EyalYe/unicorne/docs/led-map.md

# LED map

Generated by `tools/led_map.py` from the board, by walking the data chain from `LED_DIN`.
**Index** is the LED's position in the chain, 0-based (the pixel number ZMK and QMK use).
**LED** names the spot: `L K12` is the LED under the left key in row 1, column 2 of that half's
grid (thumbs `L T0`..`L T2`); `L G3` is left underglow spot 3. **Matrix** is the key's
row and column in the wired 6 x 7 matrix (left half rows 0-2, right half rows 3-5).

| Index | Ref | LED | Type | Switch | Matrix row | Matrix col | Note |
|---:|---|---|---|---|---:|---:|---|
| 0 | LED1 | L T2 | key | SW21 | 2 | 6 |  |
| 1 | LED2 | L T1 | key | SW20 | 1 | 6 |  |
| 2 | LED3 | L T0 | key | SW19 | 0 | 6 |  |
| 3 | LED4 | L G5 | underglow |  |  |  |  |
| 4 | LED5 | L K25 | key | SW18 | 2 | 5 |  |
| 5 | LED6 | L K24 | key | SW17 | 2 | 4 |  |
| 6 | LED7 | L K23 | key | SW16 | 2 | 3 |  |
| 7 | LED8 | L G4 | underglow |  |  |  |  |
| 8 | LED9 | L K22 | key | SW15 | 2 | 2 |  |
| 9 | LED10 | L K21 | key | SW14 | 2 | 1 |  |
| 10 | LED11 | L G3 | underglow |  |  |  |  |
| 11 | LED12 | L K11 | key | SW8 | 1 | 1 |  |
| 12 | LED13 | L G0 | underglow |  |  |  |  |
| 13 | LED14 | L K01 | key | SW2 | 0 | 1 |  |
| 14 | LED15 | L K02 | key | SW3 | 0 | 2 |  |
| 15 | LED16 | L K12 | key | SW9 | 1 | 2 |  |
| 16 | LED17 | L K13 | key | SW10 | 1 | 3 |  |
| 17 | LED18 | L G1 | underglow |  |  |  |  |
| 18 | LED19 | L K03 | key | SW4 | 0 | 3 |  |
| 19 | LED20 | L K04 | key | SW5 | 0 | 4 |  |
| 20 | LED21 | L K14 | key | SW11 | 1 | 4 |  |
| 21 | LED22 | L K15 | key | SW12 | 1 | 5 |  |
| 22 | LED23 | L G2 | underglow |  |  |  |  |
| 23 | LED24 | L K05 | key | SW6 | 0 | 5 |  |
| 24 | LED25 | R K05 | key | SW27 | 3 | 5 |  |
| 25 | LED26 | R G2 | underglow |  |  |  |  |
| 26 | LED27 | R K15 | key | SW33 | 4 | 5 |  |
| 27 | LED28 | R K25 | key | SW39 | 5 | 5 |  |
| 28 | LED29 | R G5 | underglow |  |  |  |  |
| 29 | LED30 | R T2 | key | SW42 | 5 | 6 |  |
| 30 | LED31 | R T1 | key | SW41 | 4 | 6 |  |
| 31 | LED32 | R T0 | key | SW40 | 3 | 6 |  |
| 32 | LED33 | R K24 | key | SW38 | 5 | 4 |  |
| 33 | LED34 | R K14 | key | SW32 | 4 | 4 |  |
| 34 | LED35 | R K04 | key | SW26 | 3 | 4 |  |
| 35 | LED36 | R K03 | key | SW25 | 3 | 3 |  |
| 36 | LED37 | R G1 | underglow |  |  |  |  |
| 37 | LED38 | R K13 | key | SW31 | 4 | 3 |  |
| 38 | LED39 | R K23 | key | SW37 | 5 | 3 |  |
| 39 | LED40 | R G4 | underglow |  |  |  |  |
| 40 | LED41 | R K22 | key | SW36 | 5 | 2 |  |
| 41 | LED42 | R K12 | key | SW30 | 4 | 2 |  |
| 42 | LED43 | R K02 | key | SW24 | 3 | 2 |  |
| 43 | LED44 | R K01 | key | SW23 | 3 | 1 |  |
| 44 | LED45 | R G0 | underglow |  |  |  |  |
| 45 | LED46 | R K11 | key | SW29 | 4 | 1 |  |
| 46 | LED47 | R G3 | underglow |  |  |  |  |
| 47 | LED48 | R K21 | key | SW35 | 5 | 1 |  |
| 48 | LED49 | R K20 | key | SW34 | 5 | 0 | outer pinky (breaks off) |
| 49 | LED50 | R K10 | key | SW28 | 4 | 0 | outer pinky (breaks off) |
| 50 | LED51 | R K00 | key | SW22 | 3 | 0 | outer pinky (breaks off) |
| 51 | LED52 | L K00 | key | SW1 | 0 | 0 | outer pinky (breaks off) |
| 52 | LED53 | L K10 | key | SW7 | 1 | 0 | outer pinky (breaks off) |
| 53 | LED54 | L K20 | key | SW13 | 2 | 0 | outer pinky (breaks off) |

54 LEDs. The outer pinky LEDs are last, so on the 36-key build the chain ends at index 47.
