EyalYe/unicorne/export/plate/unicorne-choc-42-plate.png

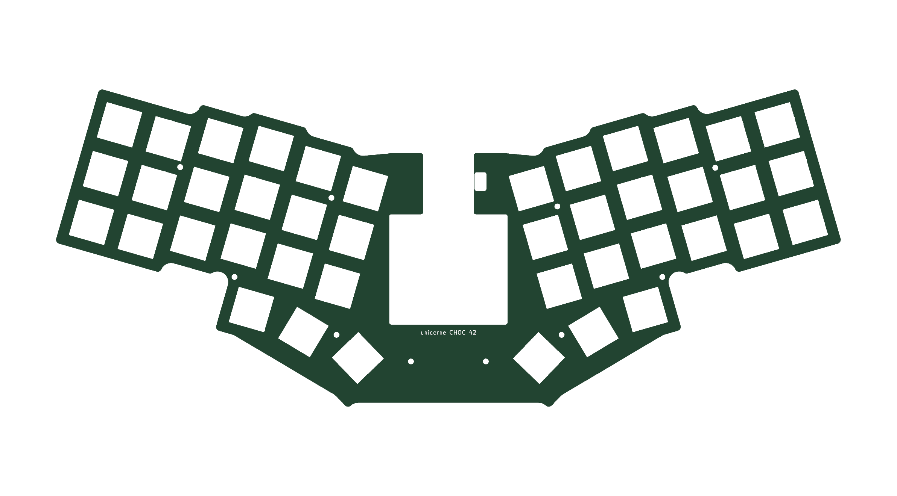
export/plate/unicorne-choc-42-plate.png
