EyalYe/unicorne/export/unicorne-choc-bottom.png

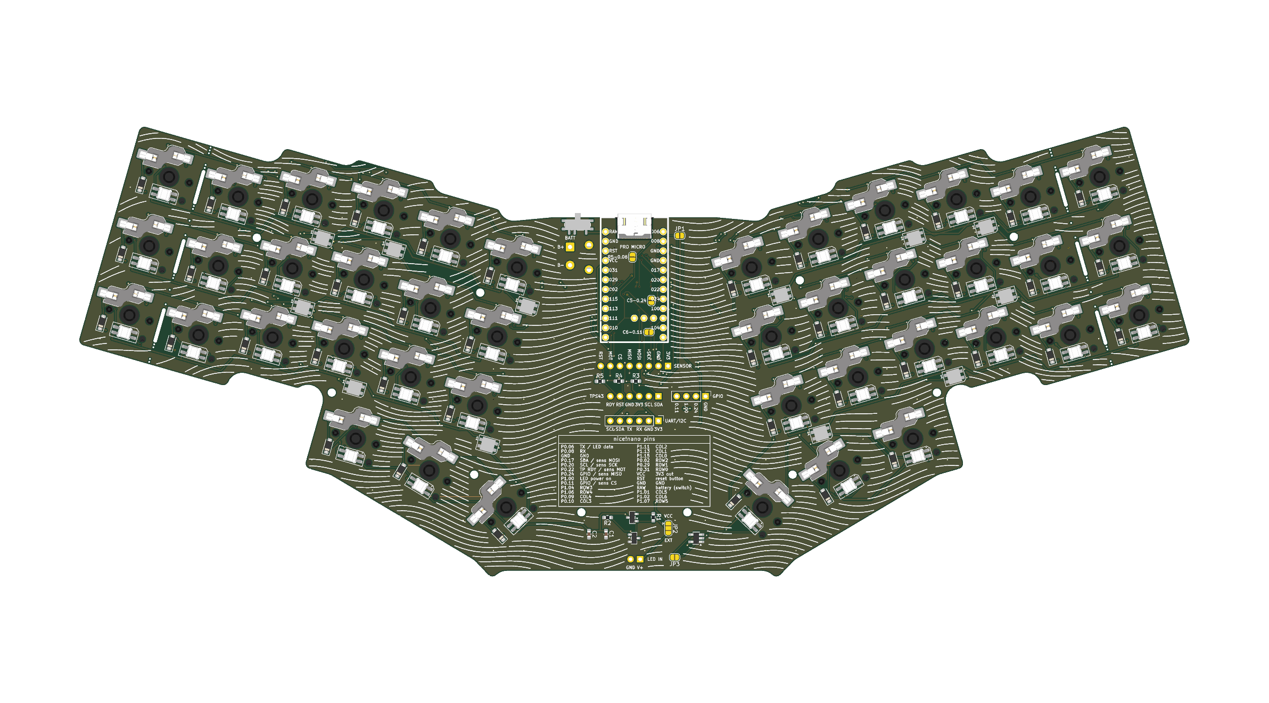
export/unicorne-choc-bottom.png
