EyalYe/unicorne/export/unicorne-mx-bottom.png

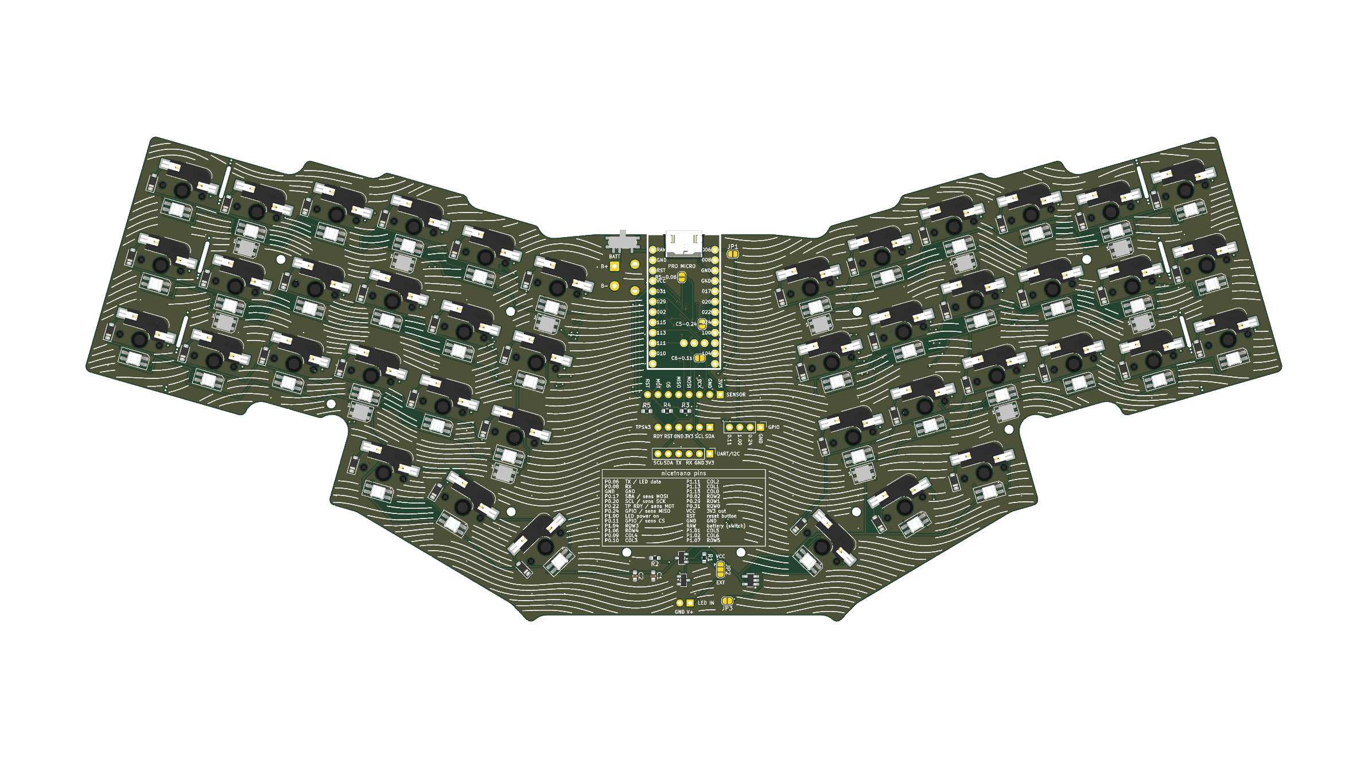
export/unicorne-mx-bottom.png
