EyalYe/unicorne/export/plate/unicorne-mx-36-plate.step

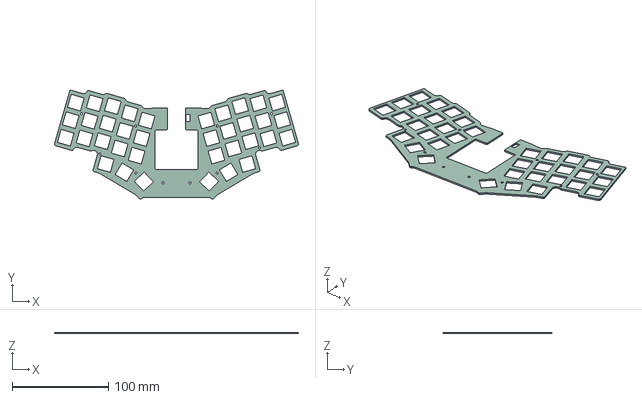
[picture p6: CAD file, 2026-10-26]
export/plate/unicorne-mx-36-plate.step
253.8 x 113.5 x 1.41 mm
