EyalYe/unicorne/export/unicorne-choc.step

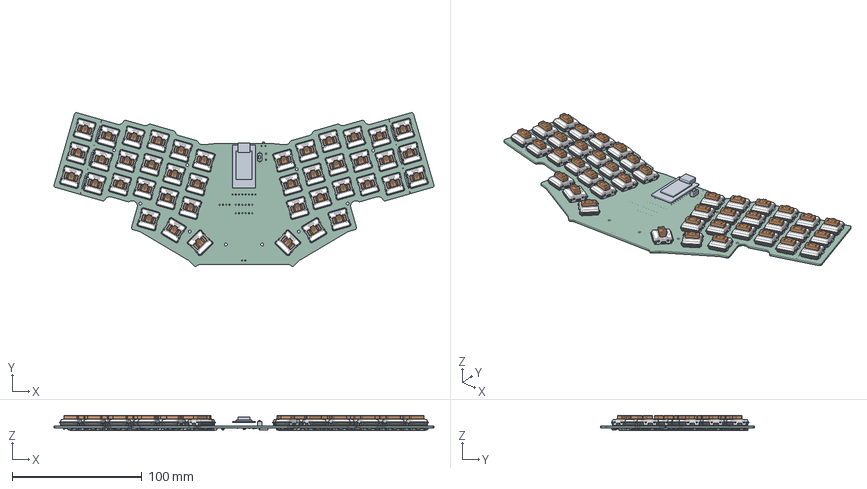
[picture p7: CAD file, 2026-10-26]
export/unicorne-choc.step
293.4 x 118.8 x 11.5 mm
SW_Hotswap_Kailh_Choc_v1 x 42
SW_Kailh_Choc_V1_cp x 42
tactile_3.5x6_h43_box
nice_nano_box
D_SOD-123 x 42
Pin1 x 42
Pin2 x 42
Pin3 x 42
Pin4 x 42
sk6812mini_box x 12
R_0603_1608Metric x 5
C_0603_1608Metric x 2
SOT-23 x 2
msk12c02_box
SOT-23-5
unicorne-choc_PCB
