EyalYe/unicorne/export/plate/unicorne-mx-42-plate.step

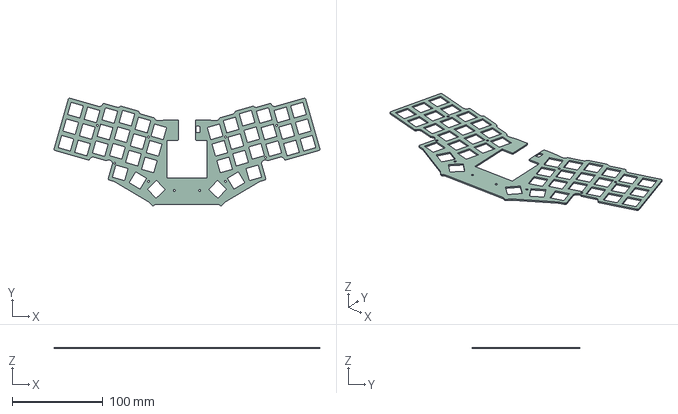
[picture p8: CAD file, 2026-10-26]
export/plate/unicorne-mx-42-plate.step
293.4 x 118.8 x 1.41 mm
