EyalYe/unicorne/export/unicorne-mx.step

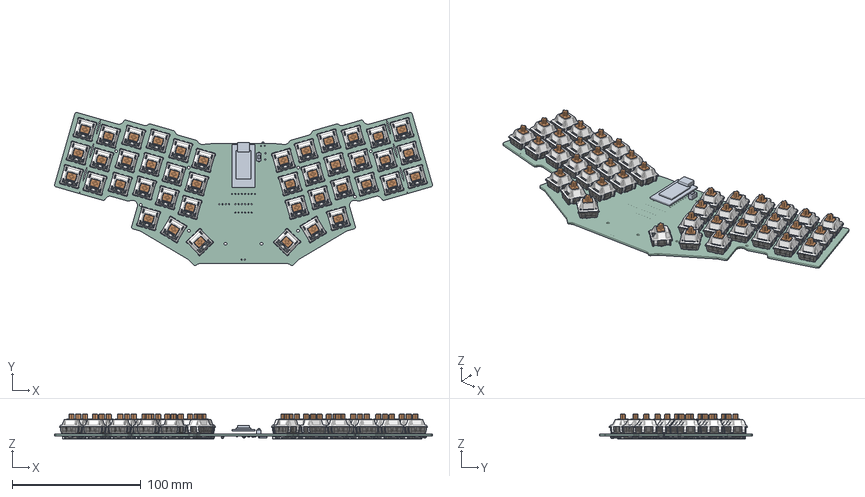
[picture p9: CAD file, 2026-10-26]
export/unicorne-mx.step
293.4 x 118.8 x 19.0 mm
SW_Hotswap_Kailh_cp x 42
SW_Cherry_MX_PCB_cp x 42
tactile_3.5x6_h43_box
nice_nano_box
sk6812mini_box x 12
Pin1 x 42
Pin2 x 42
Pin3 x 42
Pin4 x 42
D_SOD-123 x 42
msk12c02_box
R_0603_1608Metric x 5
SOT-23 x 2
C_0603_1608Metric x 2
SOT-23-5
unicorne_PCB
