EyalYe/unicorne/export/plate/unicorne-choc-36-plate.step

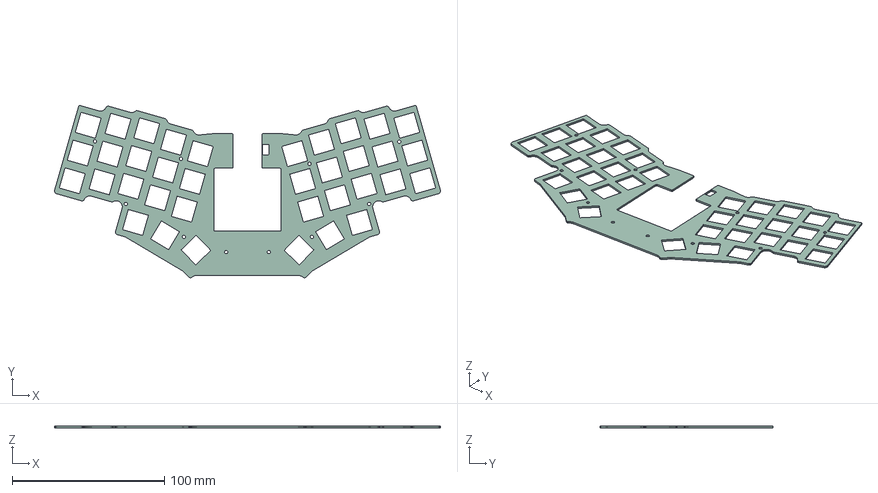
[picture p10: CAD file, 2026-10-26]
export/plate/unicorne-choc-36-plate.step
253.8 x 113.5 x 1.11 mm
