EyalYe/unicorne/export/plate/unicorne-choc-42-plate.step

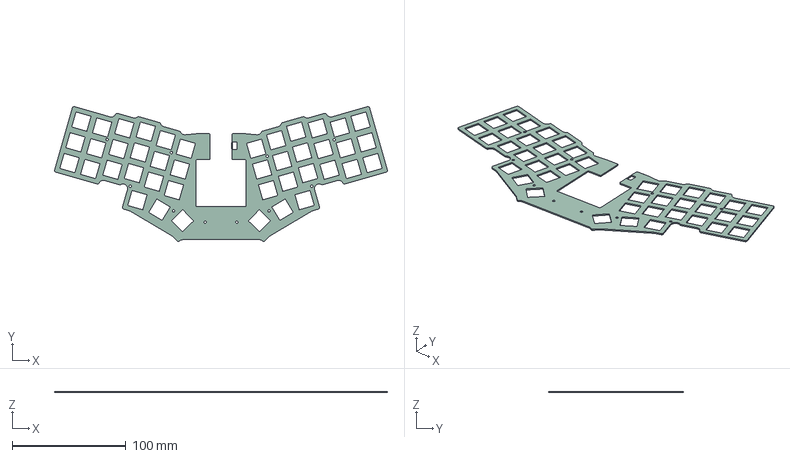
[picture p11: CAD file, 2026-10-26]
export/plate/unicorne-choc-42-plate.step
293.4 x 118.8 x 1.11 mm
