EyalYe/unicorne/export/plate/unicorne-mx-plate.dxf

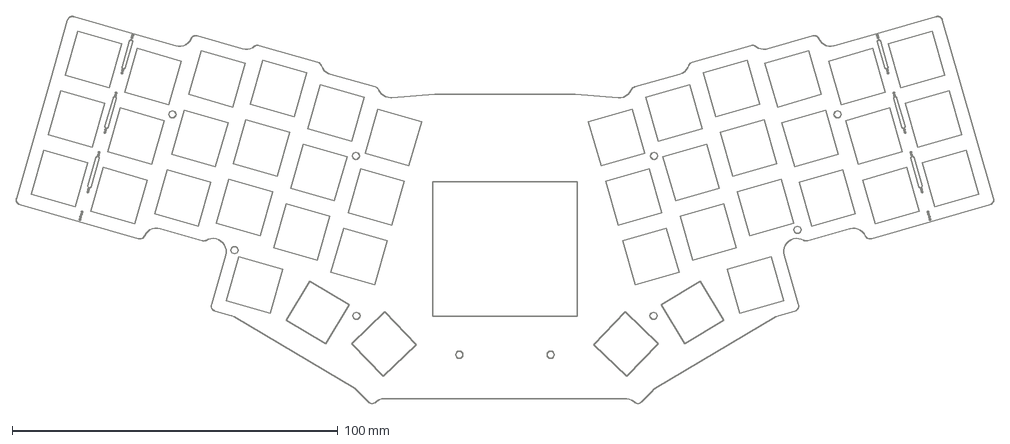
[picture p12: CAD file, 2026-10-25]
export/plate/unicorne-mx-plate.dxf
299.9 x 118.8 mm
