EyalYe/unicorne/export/plate/unicorne-choc-plate.dxf

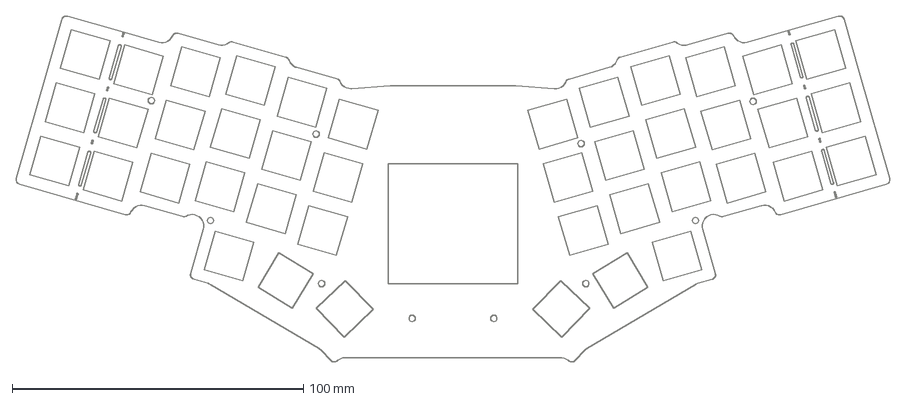
[picture p13: CAD file, 2026-10-25]
export/plate/unicorne-choc-plate.dxf
299.9 x 118.8 mm
