EyalYe/unicorne/(list of files, cad)

Other CAD files:
export/plate/unicorne-choc-36-plate.dxf
export/plate/unicorne-choc-42-plate.dxf
export/plate/unicorne-mx-36-plate.dxf
export/plate/unicorne-mx-42-plate.dxf
