EyalYe/unicorne/unicorne.kicad_pcb

## KiCad design unicorne.kicad_pcb (2026-10-26)

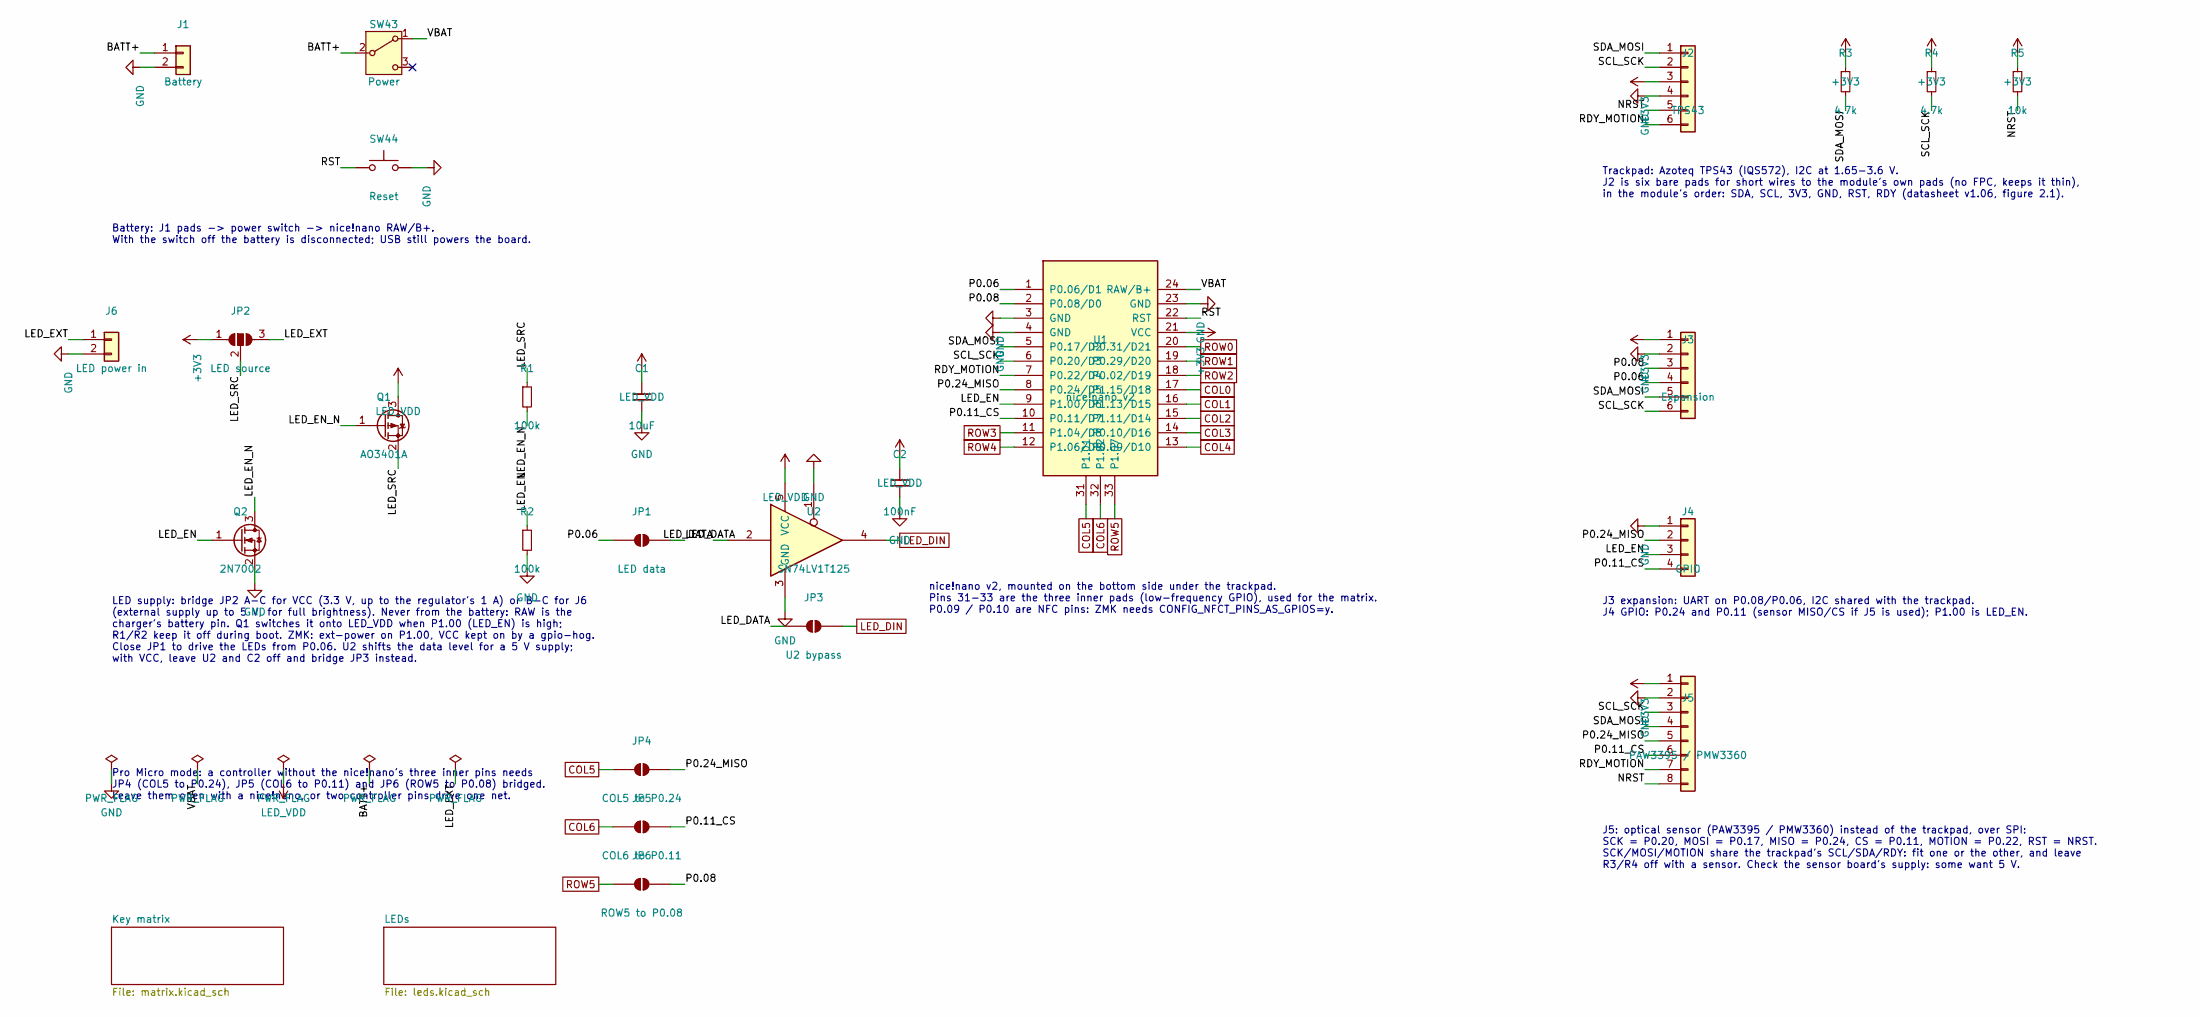
[picture p14: schematic unicorne.kicad_sch]

Parts:
C1: 10uF; C_0603_1608Metric_Pad1.08x0.95mm_HandSolder
C2: 100nF; C_0603_1608Metric_Pad1.08x0.95mm_HandSolder
J1: Battery; SolderWire-0.5sqmm_1x02_P4.8mm_D0.9mm_OD2.3mm
J2: TPS43; PinHeader_1x06_P2.54mm_Vertical
J3: Expansion; PinHeader_1x06_P2.54mm_Vertical
J4: GPIO; PinHeader_1x04_P2.54mm_Vertical
J5: PAW3395 / PMW3360; PinHeader_1x08_P2.54mm_Vertical
J6: LED power in; PinHeader_1x02_P2.54mm_Vertical
JP1: LED data; SolderJumper-2_P1.3mm_Open_RoundedPad1.0x1.5mm
JP2: LED source; SolderJumper-3_P1.3mm_Open_RoundedPad1.0x1.5mm
JP3: U2 bypass; SolderJumper-2_P1.3mm_Open_RoundedPad1.0x1.5mm
JP4: COL5 to P0.24; SolderJumper-2_P1.3mm_Open_RoundedPad1.0x1.5mm
JP5: COL6 to P0.11; SolderJumper-2_P1.3mm_Open_RoundedPad1.0x1.5mm
JP6: ROW5 to P0.08; SolderJumper-2_P1.3mm_Open_RoundedPad1.0x1.5mm
Q1: AO3401A; SOT-23
Q2: 2N7002; SOT-23
R1, R2: 100k; R_0603_1608Metric_Pad0.98x0.95mm_HandSolder
R3, R4: 4.7k; R_0603_1608Metric_Pad0.98x0.95mm_HandSolder
R5: 10k; R_0603_1608Metric_Pad0.98x0.95mm_HandSolder
SW43: Power; SW_SPDT_Shouhan_MSK12C02
SW44: Reset; SW_Tactile_SPST_3.5x6mm_H4.3mm_THT
U1: nice!nano v2; nice_nano
U2: SN74LV1T125; SOT-23-5_HandSoldering

Connections:
+3V3: J2.3, J3.1, J5.1, JP2.1 (A), R3.1, R4.1, R5.1, U1.21 (VCC)
/BATT+: J1.1, SW43.2 (B)
/LED_DATA: JP1.2 (B), JP3.1 (A), U2.2
/LED_EN: J4.3, Q2.1 (G), R2.1, U1.9 (P1.00/D6)
/LED_EN_N: Q1.1 (G), Q2.3 (D), R1.2
/LED_EXT: J6.1, JP2.3 (B)
/LED_SRC: JP2.2 (C), Q1.2 (S), R1.1
/NRST: J2.5, J5.8, R5.2
/P0.06: J3.4, JP1.1 (A), U1.1 (P0.06/D1)
/P0.08: J3.3, JP6.2 (B), U1.2 (P0.08/D0)
/P0.11_CS: J4.4, J5.6, JP5.2 (B), U1.10 (P0.11/D7)
/P0.24_MISO: J4.2, J5.5, JP4.2 (B), U1.8 (P0.24/D5)
/RDY_MOTION: J2.6, J5.7, U1.7 (P0.22/D4)
/RST: SW44.1, U1.22 (RST)
/SCL_SCK: J2.2, J3.6, J5.3, R4.2, U1.6 (P0.20/D3)
/SDA_MOSI: J2.1, J3.5, J5.4, R3.2, U1.5 (P0.17/D2)
/VBAT: SW43.1 (A), U1.24 (RAW/B+)
COL0: U1.17 (P1.15/D18); also elsewhere on the board
COL1: U1.16 (P1.13/D15); also elsewhere on the board
COL2: U1.15 (P1.11/D14); also elsewhere on the board
COL3: U1.14 (P0.10/D16); also elsewhere on the board
COL4: U1.13 (P0.09/D10); also elsewhere on the board
COL5: JP4.1 (A), U1.31 (P1.01); also elsewhere on the board
COL6: JP5.1 (A), U1.32 (P1.02); also elsewhere on the board
GND: C1.2, C2.2, J1.2, J2.4, J3.2, J4.1, J5.2, J6.2, Q2.2 (S), R2.2, SW44.2, U1.3 (GND), U1.4 (GND), U1.23 (GND), U2.1, U2.3 (GND); also elsewhere on the board
LED_DIN: JP3.2 (B), U2.4; also elsewhere on the board
LED_VDD: C1.1, C2.1, Q1.3 (D), U2.5 (VCC); also elsewhere on the board
ROW0: U1.20 (P0.31/D21); also elsewhere on the board
ROW1: U1.19 (P0.29/D20); also elsewhere on the board
ROW2: U1.18 (P0.02/D19); also elsewhere on the board
ROW3: U1.11 (P1.04/D8); also elsewhere on the board
ROW4: U1.12 (P1.06/D9); also elsewhere on the board
ROW5: JP6.1 (A), U1.33 (P1.07); also elsewhere on the board

Notes on the sheet:
nice!nano v2, mounted on the bottom side under the trackpad. Pins 31-33 are the three inner pads (low-frequency GPIO), used for the matrix. P0.09 / P0.10 are NFC pins: ZMK needs CONFIG_NFCT_PINS_AS_GPIOS=y.
Battery: J1 pads -> power switch -> nice!nano RAW/B+. With the switch off the battery is disconnected; USB still powers the board.
Pro Micro mode: a controller without the nice!nano's three inner pins needs JP4 (COL5 to P0.24), JP5 (COL6 to P0.11) and JP6 (ROW5 to P0.08) bridged. Leave them open with a nice!nano, or two controller pins drive one net.
LED supply: bridge JP2 A-C for VCC (3.3 V, up to the regulator's 1 A) or B-C for J6 (external supply up to 5 V, for full brightness). Never from the battery: RAW is the charger's battery pin. Q1 switches it onto LED_VDD when P1.00 (LED_EN) is high; R1/R2 keep it off during boot. ZMK: ext-power on P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
J5: optical sensor (PAW3395 / PMW3360) instead of the trackpad, over SPI: SCK = P0.20, MOSI = P0.17, MISO = P0.24, CS = P0.11, MOTION = P0.22, RST = NRST. SCK/MOSI/MOTION share the trackpad's SCL/SDA/RDY: fit one or the other, and leave R3/R4 off with a sensor. Check the sensor board's supply: some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
Trackpad: Azoteq TPS43 (IQS572), I2C at 1.65-3.6 V. J2 is six bare pads for short wires to the module's own pads (no FPC, keeps it thin), in the module's order: SDA, SCL, 3V3, GND, RST, RDY (datasheet v1.06, figure 2.1).
J3 expansion: UART on P0.08/P0.06, I2C shared with the trackpad. J4 GPIO: P0.24 and P0.11 (sensor MISO/CS if J5 is used); P1.00 is LED_EN.

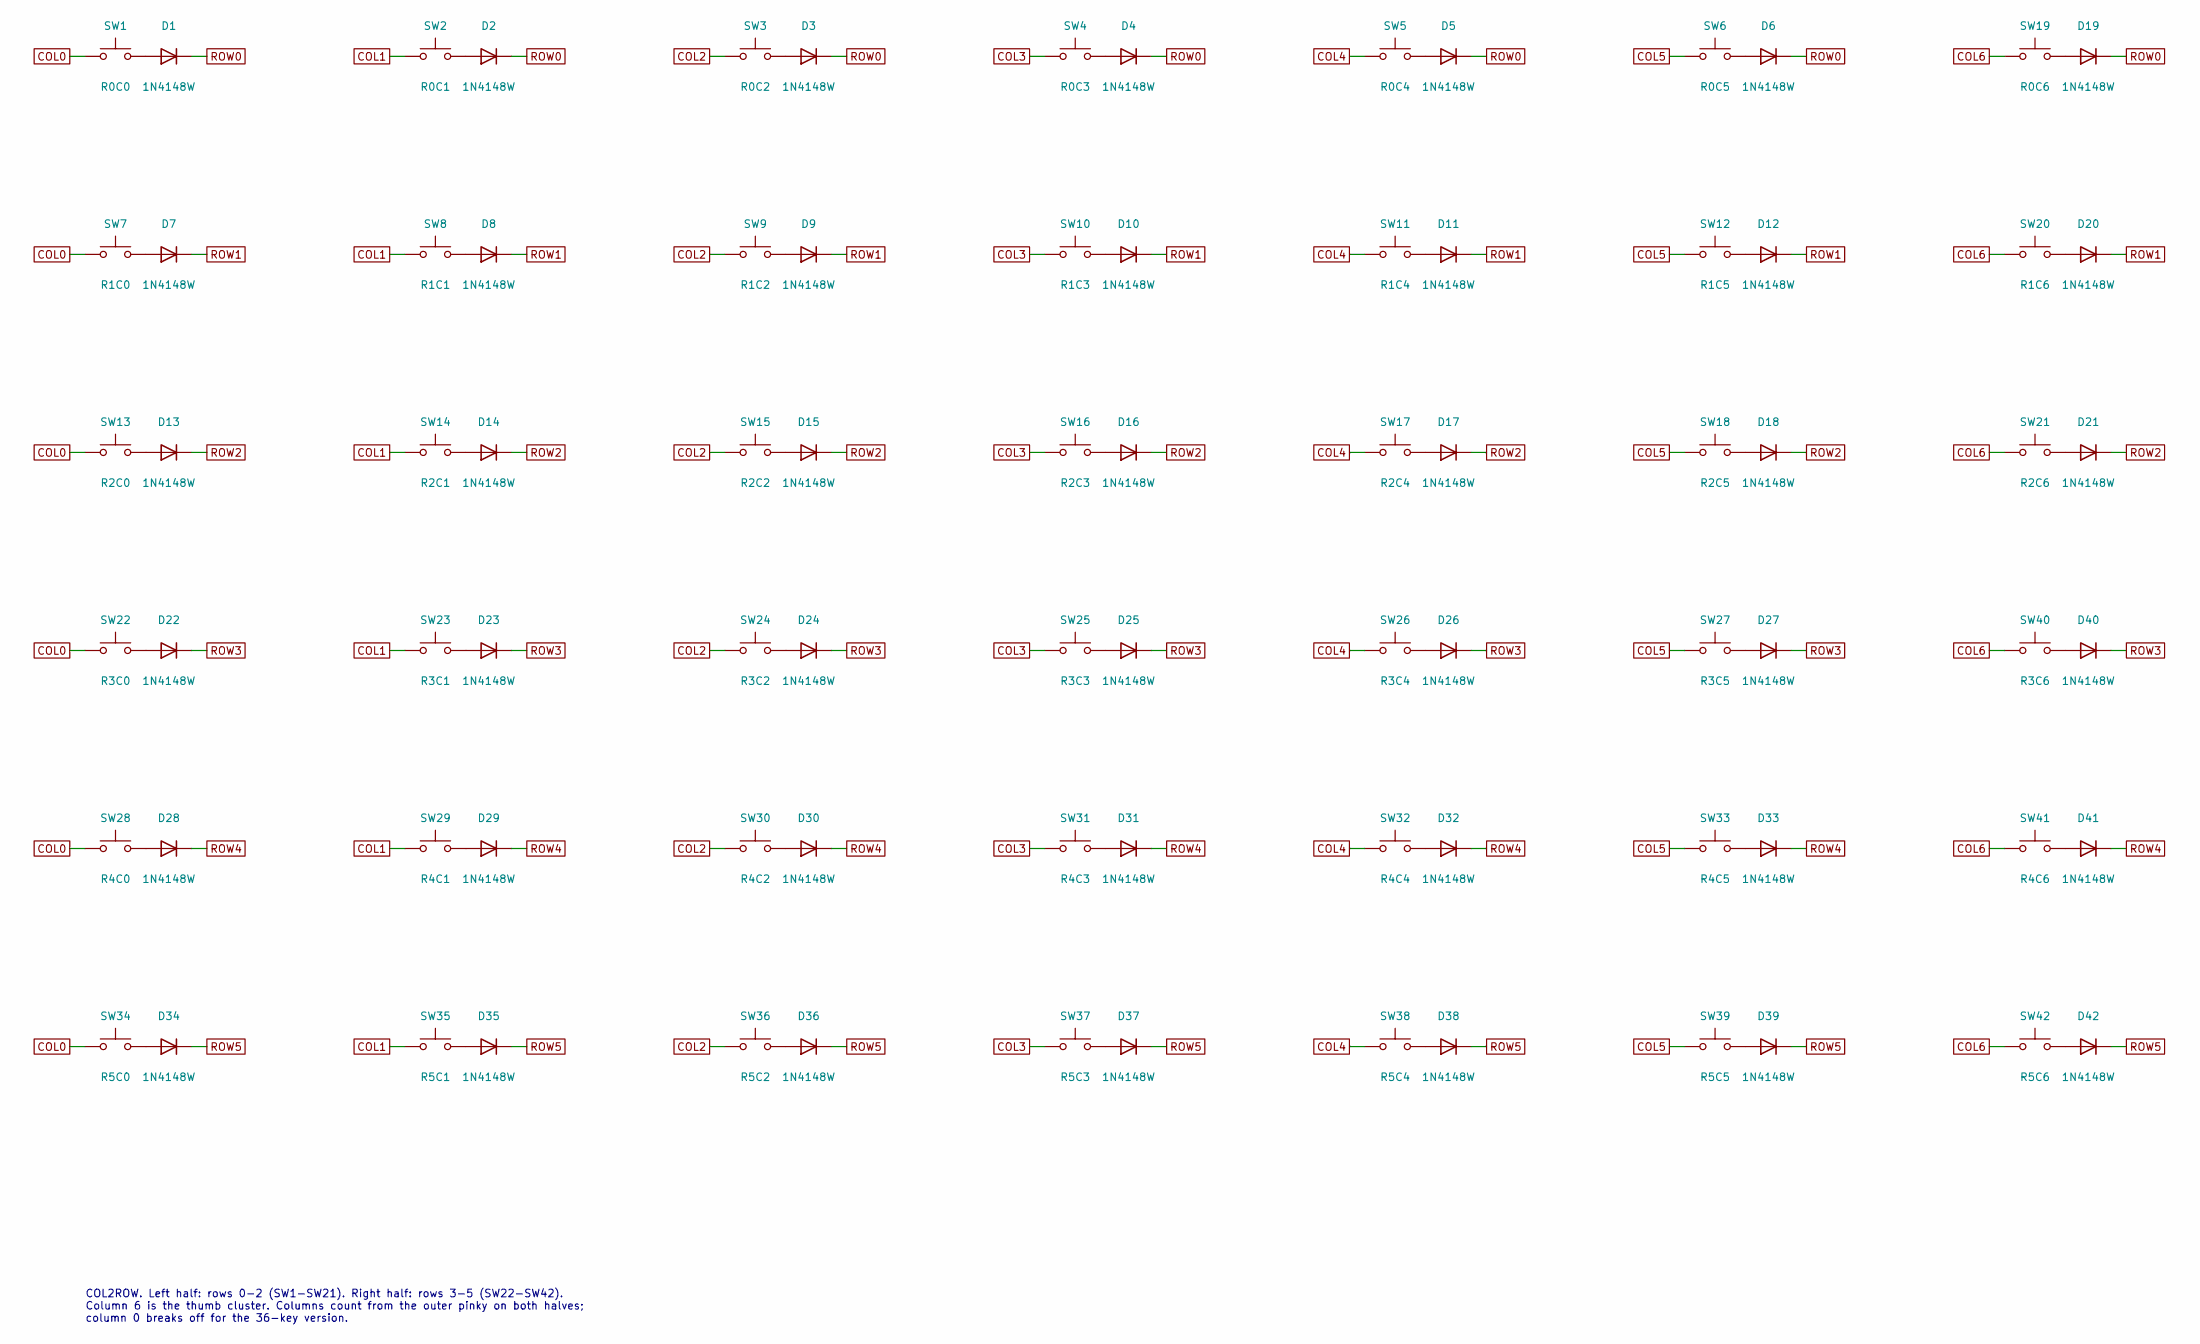
[picture p15: schematic matrix.kicad_sch, unicorne - key matrix]

Parts:
D1, D2, D3, D4, D5, D6, D7, D8, D9, D10, D11, D12, D13, D14, D15, D16, D17, D18, D19, D20, D21, D22, D23, D24, D25, D26, D27, D28, D29, D30, D31, D32, D33, D34, D35, D36, D37, D38, D39, D40, D41, D42: 1N4148W; D_SOD-123
SW1: R0C0; SW_Hotswap_Kailh_MX_1.00u
SW2: R0C1; SW_Hotswap_Kailh_MX_1.00u
SW3: R0C2; SW_Hotswap_Kailh_MX_1.00u
SW4: R0C3; SW_Hotswap_Kailh_MX_1.00u
SW5: R0C4; SW_Hotswap_Kailh_MX_1.00u
SW6: R0C5; SW_Hotswap_Kailh_MX_1.00u
SW7: R1C0; SW_Hotswap_Kailh_MX_1.00u
SW8: R1C1; SW_Hotswap_Kailh_MX_1.00u
SW9: R1C2; SW_Hotswap_Kailh_MX_1.00u
SW10: R1C3; SW_Hotswap_Kailh_MX_1.00u
SW11: R1C4; SW_Hotswap_Kailh_MX_1.00u
SW12: R1C5; SW_Hotswap_Kailh_MX_1.00u
SW13: R2C0; SW_Hotswap_Kailh_MX_1.00u
SW14: R2C1; SW_Hotswap_Kailh_MX_1.00u
SW15: R2C2; SW_Hotswap_Kailh_MX_1.00u
SW16: R2C3; SW_Hotswap_Kailh_MX_1.00u
SW17: R2C4; SW_Hotswap_Kailh_MX_1.00u
SW18: R2C5; SW_Hotswap_Kailh_MX_1.00u
SW19: R0C6; SW_Hotswap_Kailh_MX_1.00u
SW20: R1C6; SW_Hotswap_Kailh_MX_1.00u
SW21: R2C6; SW_Hotswap_Kailh_MX_1.50u
SW22: R3C0; SW_Hotswap_Kailh_MX_1.00u
SW23: R3C1; SW_Hotswap_Kailh_MX_1.00u
SW24: R3C2; SW_Hotswap_Kailh_MX_1.00u
SW25: R3C3; SW_Hotswap_Kailh_MX_1.00u
SW26: R3C4; SW_Hotswap_Kailh_MX_1.00u
SW27: R3C5; SW_Hotswap_Kailh_MX_1.00u
SW28: R4C0; SW_Hotswap_Kailh_MX_1.00u
SW29: R4C1; SW_Hotswap_Kailh_MX_1.00u
SW30: R4C2; SW_Hotswap_Kailh_MX_1.00u
SW31: R4C3; SW_Hotswap_Kailh_MX_1.00u
SW32: R4C4; SW_Hotswap_Kailh_MX_1.00u
SW33: R4C5; SW_Hotswap_Kailh_MX_1.00u
SW34: R5C0; SW_Hotswap_Kailh_MX_1.00u
SW35: R5C1; SW_Hotswap_Kailh_MX_1.00u
SW36: R5C2; SW_Hotswap_Kailh_MX_1.00u
SW37: R5C3; SW_Hotswap_Kailh_MX_1.00u
SW38: R5C4; SW_Hotswap_Kailh_MX_1.00u
SW39: R5C5; SW_Hotswap_Kailh_MX_1.00u
SW40: R3C6; SW_Hotswap_Kailh_MX_1.00u
SW41: R4C6; SW_Hotswap_Kailh_MX_1.00u
SW42: R5C6; SW_Hotswap_Kailh_MX_1.50u

Connections:
COL0: SW1.1, SW7.1, SW13.1, SW22.1, SW28.1, SW34.1; also elsewhere on the board
COL1: SW2.1, SW8.1, SW14.1, SW23.1, SW29.1, SW35.1; also elsewhere on the board
COL2: SW3.1, SW9.1, SW15.1, SW24.1, SW30.1, SW36.1; also elsewhere on the board
COL3: SW4.1, SW10.1, SW16.1, SW25.1, SW31.1, SW37.1; also elsewhere on the board
COL4: SW5.1, SW11.1, SW17.1, SW26.1, SW32.1, SW38.1; also elsewhere on the board
COL5: SW6.1, SW12.1, SW18.1, SW27.1, SW33.1, SW39.1; also elsewhere on the board
COL6: SW19.1, SW20.1, SW21.1, SW40.1, SW41.1, SW42.1; also elsewhere on the board
unnamed: D1.2 (A), SW1.2
unnamed: D2.2 (A), SW2.2
unnamed: D3.2 (A), SW3.2
unnamed: D4.2 (A), SW4.2
unnamed: D5.2 (A), SW5.2
unnamed: D6.2 (A), SW6.2
unnamed: D7.2 (A), SW7.2
unnamed: D8.2 (A), SW8.2
unnamed: D9.2 (A), SW9.2
unnamed: D10.2 (A), SW10.2
unnamed: D11.2 (A), SW11.2
unnamed: D12.2 (A), SW12.2
unnamed: D13.2 (A), SW13.2
unnamed: D14.2 (A), SW14.2
unnamed: D15.2 (A), SW15.2
unnamed: D16.2 (A), SW16.2
unnamed: D17.2 (A), SW17.2
unnamed: D18.2 (A), SW18.2
unnamed: D19.2 (A), SW19.2
unnamed: D20.2 (A), SW20.2
unnamed: D21.2 (A), SW21.2
unnamed: D22.2 (A), SW22.2
unnamed: D23.2 (A), SW23.2
unnamed: D24.2 (A), SW24.2
unnamed: D25.2 (A), SW25.2
unnamed: D26.2 (A), SW26.2
unnamed: D27.2 (A), SW27.2
unnamed: D28.2 (A), SW28.2
unnamed: D29.2 (A), SW29.2
unnamed: D30.2 (A), SW30.2
unnamed: D31.2 (A), SW31.2
unnamed: D32.2 (A), SW32.2
unnamed: D33.2 (A), SW33.2
unnamed: D34.2 (A), SW34.2
unnamed: D35.2 (A), SW35.2
unnamed: D36.2 (A), SW36.2
unnamed: D37.2 (A), SW37.2
unnamed: D38.2 (A), SW38.2
unnamed: D39.2 (A), SW39.2
unnamed: D40.2 (A), SW40.2
unnamed: D41.2 (A), SW41.2
unnamed: D42.2 (A), SW42.2
ROW0: D1.1 (K), D2.1 (K), D3.1 (K), D4.1 (K), D5.1 (K), D6.1 (K), D19.1 (K); also elsewhere on the board
ROW1: D7.1 (K), D8.1 (K), D9.1 (K), D10.1 (K), D11.1 (K), D12.1 (K), D20.1 (K); also elsewhere on the board
ROW2: D13.1 (K), D14.1 (K), D15.1 (K), D16.1 (K), D17.1 (K), D18.1 (K), D21.1 (K); also elsewhere on the board
ROW3: D22.1 (K), D23.1 (K), D24.1 (K), D25.1 (K), D26.1 (K), D27.1 (K), D40.1 (K); also elsewhere on the board
ROW4: D28.1 (K), D29.1 (K), D30.1 (K), D31.1 (K), D32.1 (K), D33.1 (K), D41.1 (K); also elsewhere on the board
ROW5: D34.1 (K), D35.1 (K), D36.1 (K), D37.1 (K), D38.1 (K), D39.1 (K), D42.1 (K); also elsewhere on the board

Notes on the sheet:
COL2ROW. Left half: rows 0-2 (SW1-SW21). Right half: rows 3-5 (SW22-SW42). Column 6 is the thumb cluster. Columns count from the outer pinky on both halves; column 0 breaks off for the 36-key version.

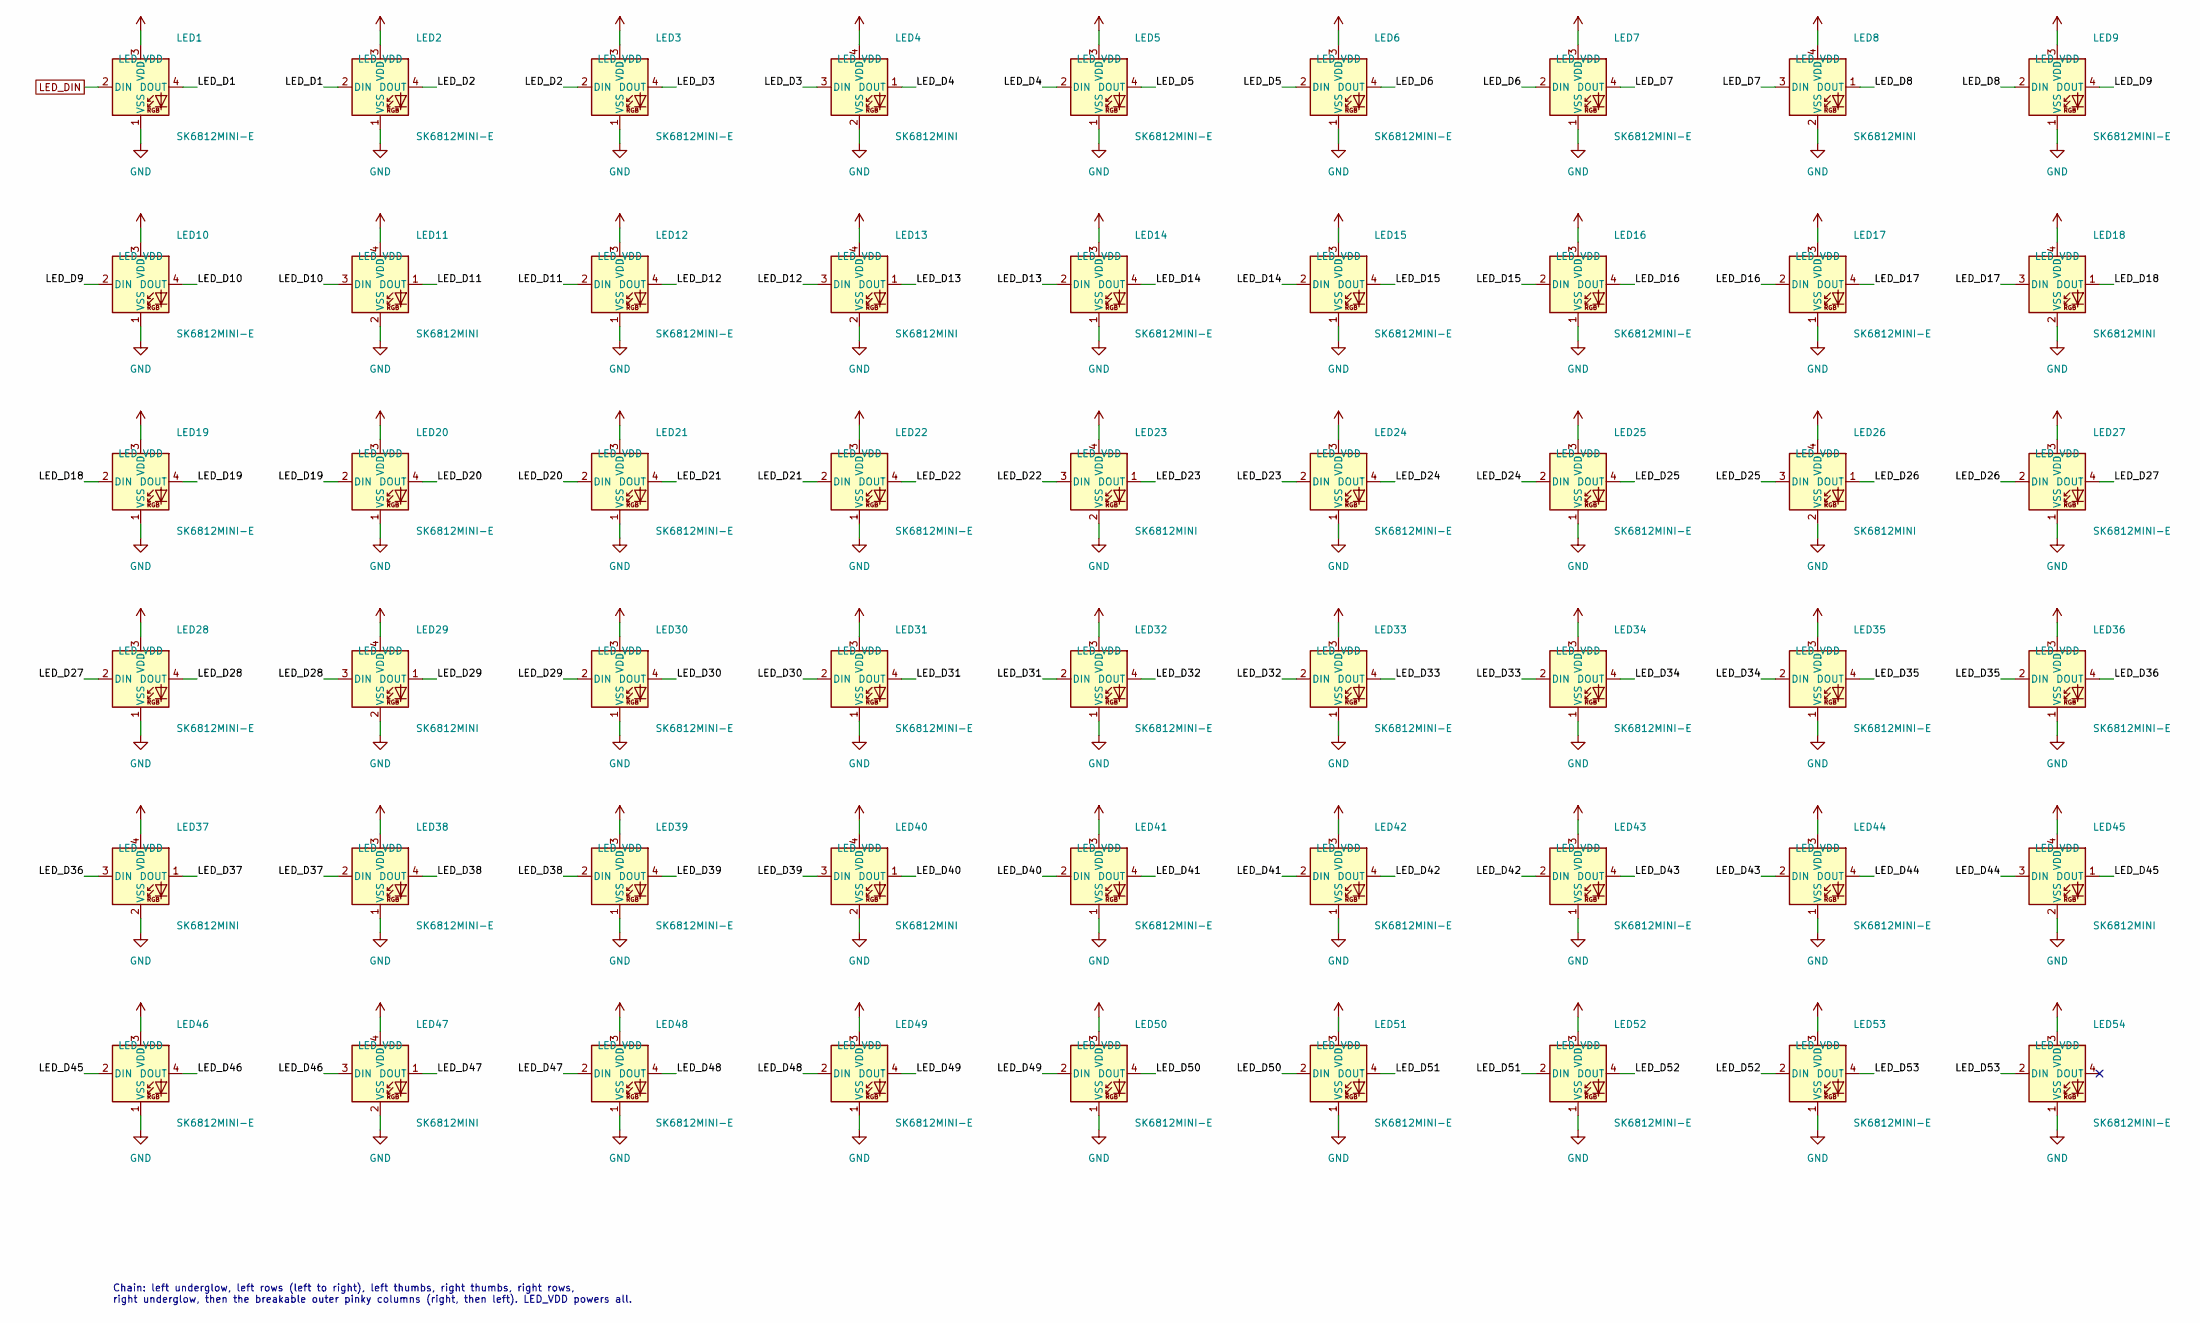
[picture p16: schematic leds.kicad_sch, unicorne - LEDs]

Parts:
LED1, LED2, LED3, LED5, LED6, LED7, LED9, LED10, LED12, LED14, LED15, LED16, LED17, LED19, LED20, LED21, LED22, LED24, LED25, LED27, LED28, LED30, LED31, LED32, LED33, LED34, LED35, LED36, LED38, LED39, LED41, LED42, LED43, LED44, LED46, LED48, LED49, LED50, LED51, LED52, LED53, LED54: SK6812MINI-E; LED_SK6812MINI-E_3.2x2.8mm_P1.5mm_ReverseMount
LED4, LED8, LED11, LED13, LED18, LED23, LED26, LED29, LED37, LED40, LED45, LED47: SK6812MINI; LED_SK6812MINI_PLCC4_3.5x3.5mm_P1.75mm

Connections:
/LEDs/LED_D1: LED1.4 (DOUT), LED2.2 (DIN)
/LEDs/LED_D2: LED2.4 (DOUT), LED3.2 (DIN)
/LEDs/LED_D3: LED3.4 (DOUT), LED4.3 (DIN)
/LEDs/LED_D4: LED4.1 (DOUT), LED5.2 (DIN)
/LEDs/LED_D5: LED5.4 (DOUT), LED6.2 (DIN)
/LEDs/LED_D6: LED6.4 (DOUT), LED7.2 (DIN)
/LEDs/LED_D7: LED7.4 (DOUT), LED8.3 (DIN)
/LEDs/LED_D8: LED8.1 (DOUT), LED9.2 (DIN)
/LEDs/LED_D9: LED9.4 (DOUT), LED10.2 (DIN)
/LEDs/LED_D10: LED10.4 (DOUT), LED11.3 (DIN)
/LEDs/LED_D11: LED11.1 (DOUT), LED12.2 (DIN)
/LEDs/LED_D12: LED12.4 (DOUT), LED13.3 (DIN)
/LEDs/LED_D13: LED13.1 (DOUT), LED14.2 (DIN)
/LEDs/LED_D14: LED14.4 (DOUT), LED15.2 (DIN)
/LEDs/LED_D15: LED15.4 (DOUT), LED16.2 (DIN)
/LEDs/LED_D16: LED16.4 (DOUT), LED17.2 (DIN)
/LEDs/LED_D17: LED17.4 (DOUT), LED18.3 (DIN)
/LEDs/LED_D18: LED18.1 (DOUT), LED19.2 (DIN)
/LEDs/LED_D19: LED19.4 (DOUT), LED20.2 (DIN)
/LEDs/LED_D20: LED20.4 (DOUT), LED21.2 (DIN)
/LEDs/LED_D21: LED21.4 (DOUT), LED22.2 (DIN)
/LEDs/LED_D22: LED22.4 (DOUT), LED23.3 (DIN)
/LEDs/LED_D23: LED23.1 (DOUT), LED24.2 (DIN)
/LEDs/LED_D24: LED24.4 (DOUT), LED25.2 (DIN)
/LEDs/LED_D25: LED25.4 (DOUT), LED26.3 (DIN)
/LEDs/LED_D26: LED26.1 (DOUT), LED27.2 (DIN)
/LEDs/LED_D27: LED27.4 (DOUT), LED28.2 (DIN)
/LEDs/LED_D28: LED28.4 (DOUT), LED29.3 (DIN)
/LEDs/LED_D29: LED29.1 (DOUT), LED30.2 (DIN)
/LEDs/LED_D30: LED30.4 (DOUT), LED31.2 (DIN)
/LEDs/LED_D31: LED31.4 (DOUT), LED32.2 (DIN)
/LEDs/LED_D32: LED32.4 (DOUT), LED33.2 (DIN)
/LEDs/LED_D33: LED33.4 (DOUT), LED34.2 (DIN)
/LEDs/LED_D34: LED34.4 (DOUT), LED35.2 (DIN)
/LEDs/LED_D35: LED35.4 (DOUT), LED36.2 (DIN)
/LEDs/LED_D36: LED36.4 (DOUT), LED37.3 (DIN)
/LEDs/LED_D37: LED37.1 (DOUT), LED38.2 (DIN)
/LEDs/LED_D38: LED38.4 (DOUT), LED39.2 (DIN)
/LEDs/LED_D39: LED39.4 (DOUT), LED40.3 (DIN)
/LEDs/LED_D40: LED40.1 (DOUT), LED41.2 (DIN)
/LEDs/LED_D41: LED41.4 (DOUT), LED42.2 (DIN)
/LEDs/LED_D42: LED42.4 (DOUT), LED43.2 (DIN)
/LEDs/LED_D43: LED43.4 (DOUT), LED44.2 (DIN)
/LEDs/LED_D44: LED44.4 (DOUT), LED45.3 (DIN)
/LEDs/LED_D45: LED45.1 (DOUT), LED46.2 (DIN)
/LEDs/LED_D46: LED46.4 (DOUT), LED47.3 (DIN)
/LEDs/LED_D47: LED47.1 (DOUT), LED48.2 (DIN)
/LEDs/LED_D48: LED48.4 (DOUT), LED49.2 (DIN)
/LEDs/LED_D49: LED49.4 (DOUT), LED50.2 (DIN)
/LEDs/LED_D50: LED50.4 (DOUT), LED51.2 (DIN)
/LEDs/LED_D51: LED51.4 (DOUT), LED52.2 (DIN)
/LEDs/LED_D52: LED52.4 (DOUT), LED53.2 (DIN)
/LEDs/LED_D53: LED53.4 (DOUT), LED54.2 (DIN)
GND: LED1.1 (VSS), LED2.1 (VSS), LED3.1 (VSS), LED4.2 (VSS), LED5.1 (VSS), LED6.1 (VSS), LED7.1 (VSS), LED8.2 (VSS), LED9.1 (VSS), LED10.1 (VSS), LED11.2 (VSS), LED12.1 (VSS), LED13.2 (VSS), LED14.1 (VSS), LED15.1 (VSS), LED16.1 (VSS), LED17.1 (VSS), LED18.2 (VSS), LED19.1 (VSS), LED20.1 (VSS), LED21.1 (VSS), LED22.1 (VSS), LED23.2 (VSS), LED24.1 (VSS), LED25.1 (VSS), LED26.2 (VSS), LED27.1 (VSS), LED28.1 (VSS), LED29.2 (VSS), LED30.1 (VSS), LED31.1 (VSS), LED32.1 (VSS), LED33.1 (VSS), LED34.1 (VSS), LED35.1 (VSS), LED36.1 (VSS), LED37.2 (VSS), LED38.1 (VSS), LED39.1 (VSS), LED40.2 (VSS), LED41.1 (VSS), LED42.1 (VSS), LED43.1 (VSS), LED44.1 (VSS), LED45.2 (VSS), LED46.1 (VSS), LED47.2 (VSS), LED48.1 (VSS), LED49.1 (VSS), LED50.1 (VSS), LED51.1 (VSS), LED52.1 (VSS), LED53.1 (VSS), LED54.1 (VSS); also elsewhere on the board
LED_DIN: LED1.2 (DIN); also elsewhere on the board
LED_VDD: LED1.3 (VDD), LED2.3 (VDD), LED3.3 (VDD), LED4.4 (VDD), LED5.3 (VDD), LED6.3 (VDD), LED7.3 (VDD), LED8.4 (VDD), LED9.3 (VDD), LED10.3 (VDD), LED11.4 (VDD), LED12.3 (VDD), LED13.4 (VDD), LED14.3 (VDD), LED15.3 (VDD), LED16.3 (VDD), LED17.3 (VDD), LED18.4 (VDD), LED19.3 (VDD), LED20.3 (VDD), LED21.3 (VDD), LED22.3 (VDD), LED23.4 (VDD), LED24.3 (VDD), LED25.3 (VDD), LED26.4 (VDD), LED27.3 (VDD), LED28.3 (VDD), LED29.4 (VDD), LED30.3 (VDD), LED31.3 (VDD), LED32.3 (VDD), LED33.3 (VDD), LED34.3 (VDD), LED35.3 (VDD), LED36.3 (VDD), LED37.4 (VDD), LED38.3 (VDD), LED39.3 (VDD), LED40.4 (VDD), LED41.3 (VDD), LED42.3 (VDD), LED43.3 (VDD), LED44.3 (VDD), LED45.4 (VDD), LED46.3 (VDD), LED47.4 (VDD), LED48.3 (VDD), LED49.3 (VDD), LED50.3 (VDD), LED51.3 (VDD), LED52.3 (VDD), LED53.3 (VDD), LED54.3 (VDD); also elsewhere on the board

Notes on the sheet:
Chain: left underglow, left rows (left to right), left thumbs, right thumbs, right rows, right underglow, then the breakable outer pinky columns (right, then left). LED_VDD powers all.

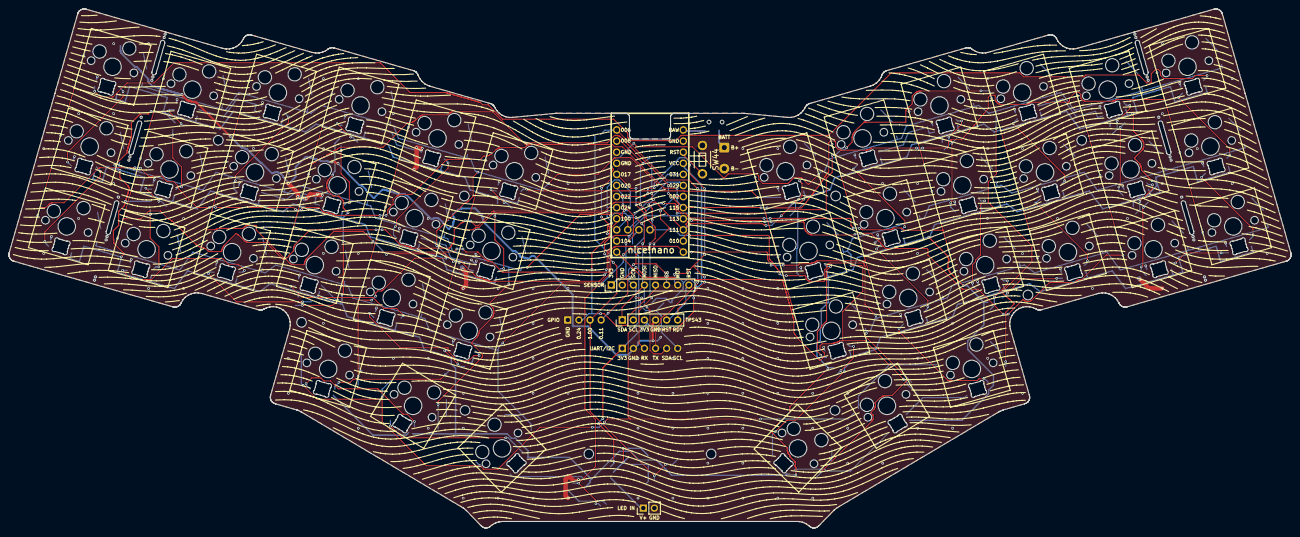
[picture p17: board unicorne.kicad_pcb from above]

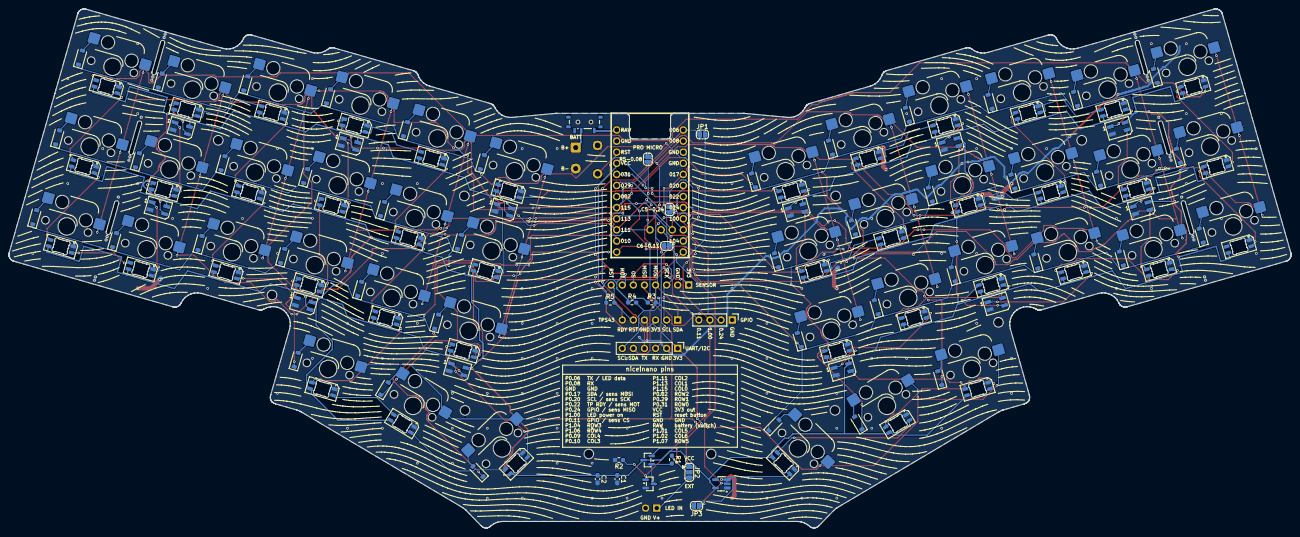
[picture p18: board unicorne.kicad_pcb from below]

Board: 2 copper layers, 293.4 x 118.8 mm, 175 parts (116 on the bottom side), 128 nets.

Other parts of the board:
H1, H2, H3, H4, H5, H6, H7, H8, H9, H10: M2; MountingHole_2.2mm_M2_ISO7380
MB1, MB2: mouse bites
