EyalYe/unicorne/(commit log)

2026-10-24 Initial KiCad 10 project skeleton
    [unicorne.kicad_pcb, unicorne.kicad_sch]
2026-10-24 Add 16° layout, trackpad mock and generated schematic
    Layout script derives key positions from crkbd v3-final and places a
    TPS43 trackpad and bottom-mounted nice!nano in the centre. The schematic
    generator builds the main, key matrix and LED sheets from that layout.
    [leds.kicad_sch, matrix.kicad_sch, unicorne.kicad_sch]
2026-10-24 Use a 6x6x5 mm through-hole tactile switch for reset
    [leds.kicad_sch, matrix.kicad_sch, unicorne.kicad_sch]
2026-10-24 Place MX and Choc PCBs from the layout and schematic
    gen_pcb.py builds both boards: switches, diodes and LEDs from Corne v3
    offsets, the nice!nano flush on the bottom, centre parts, outline,
    36-key break lines with mouse bites, M2 holes, pad labels and a
    nice!nano pin table on the silkscreen. Adds TPS43 / PAW3395-PMW3360
    sensor pads and a 6x6 THT reset switch; underglow becomes SK6812MINI.
    [leds.kicad_sch, matrix.kicad_sch, unicorne-choc.kicad_pcb, unicorne.kicad_pcb, unicorne.kicad_sch]
2026-10-24 Rework LED power, break lines and centre placement; add routing tools
    - LED supply chosen by solder jumper JP2: nice!nano VCC, or an external
    supply on new LED IN pads (J6); never the battery pin. SN74LV1T125
    level shifter (U2) with bypass jumper JP3.
    - Centre parts rearranged so the nice!nano's matrix pins are clear.
    - 0805 hand-solder passives; LED chain runs left to right per row.
    - Break lines: no sliver slots, perforated end to end, tabs over the lanes.
    - Mounting holes stay inside the board and off the routing lanes.
    - Routing tools (lanes, Freerouting driver, maze router) and placeholder
    STEP models. Boards are committed placed but unrouted.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
    [leds.kicad_sch, matrix.kicad_sch, unicorne-choc.kicad_pcb, unicorne.kicad_pcb, unicorne.kicad_sch]
2026-10-24 Route the MX board
    finish_route.py lays fixed lanes on the key grid (columns on top; rows,
    LED data and LED supply on the bottom), then routes KiCad's remaining
    ratsnest with the maze router, pours GND on both layers and stitches
    them. DRC: 0 unconnected, 0 copper violations, matches the schematic.
    LED chain reordered to cross the board once; Q1 rotated so its source
    faces JP2.
    [leds.kicad_sch, matrix.kicad_sch, unicorne.kicad_pcb, unicorne.kicad_sch]
2026-10-24 Route the Choc board
    lanes.py now has per-switch-type lane layouts. Choc: rows run above the
    sockets (y -8.0), reached from each cathode by a short top-layer hop
    between the switch holes; LED data and supply below the diode; where the
    next column sits lower the row lane jogs on the top layer. Break-line
    tabs and mounting-hole keep-outs follow the lanes, and finish_route.py
    nudges any hole the lanes still touch and retries failed connections
    first. MX routing is unchanged.
    DRC (Choc): 0 unconnected, 0 copper violations.
    [unicorne-choc.kicad_pcb, unicorne.kicad_pcb]
2026-10-24 Add 3D models and STEP export
    Project footprints point at models in lib/3d/: Kailh MX and Choc hotswap
    sockets and the Choc V1 switch (keyswitch-kicad-library), plus placeholder
    boxes for the nice!nano, TPS43, MX switch, SK6812MINI and MSK-12C02 (the
    last two copied from the stock library with a model added). The trackpad
    model sits on a board-only footprint; bare pads carry no model.
    export_3d.py writes export/unicorne-{mx,choc}.step; renders alongside.
    Both boards regenerated and re-routed: DRC 0 unconnected, 0 copper
    violations.
    [leds.kicad_sch, matrix.kicad_sch, unicorne-choc.kicad_pcb, unicorne-choc.step, unicorne-mx.step, unicorne.kicad_pcb, unicorne.kicad_sch]
2026-10-24 Add JLCPCB gerbers for both boards
    export_gerbers.py checks DRC, then writes 2-layer gerbers (Protel
    extensions, silkscreen clipped by mask, zones refilled) and Excellon
    drills (mm, PTH/NPTH separate) zipped per board in export/jlcpcb/.
    README gains ordering settings.
2026-10-24 Use the Cherry MX switch model on the MX board
    Replaces the placeholder box with SW_Cherry_MX_PCB.stp from
    keyswitch-kicad-library (pins match the hotswap footprint). Only the model
    path changes, so routing and gerbers are untouched. STEP and render
    re-exported.
    [unicorne-choc.step, unicorne-mx.step, unicorne.kicad_pcb]
2026-10-25 Add MX and Choc switch plates with JLCPCB, DXF and STEP exports
    [unicorne-choc-plate.dxf, unicorne-choc-plate.kicad_pcb, unicorne-choc-plate.step, unicorne-mx-plate.dxf, unicorne-mx-plate.kicad_pcb, unicorne-mx-plate.step]
2026-10-25 Add wavy silkscreen pattern to the switch plates
    [unicorne-choc-plate.dxf, unicorne-choc-plate.kicad_pcb, unicorne-choc-plate.step, unicorne-mx-plate.dxf, unicorne-mx-plate.kicad_pcb, unicorne-mx-plate.step]
2026-10-25 Regenerate JLCPCB gerbers for the PCBs and plates
    [unicorne-choc-plate.dxf, unicorne-choc-plate.kicad_pcb, unicorne-choc-plate.step, unicorne-mx-plate.dxf, unicorne-mx-plate.kicad_pcb, unicorne-mx-plate.step]
2026-10-25 Export plate gerbers with empty copper layers so JLCPCB's viewer shows the silkscreen
    [unicorne-choc-plate.dxf, unicorne-choc-plate.kicad_pcb, unicorne-choc-plate.step, unicorne-mx-plate.dxf, unicorne-mx-plate.kicad_pcb, unicorne-mx-plate.step]
2026-10-25 Move the wavy silkscreen from the plates to both sides of the PCBs
    tools/waves.py draws the waves on the routed boards in a replaceable group,
    clear of courtyards, pads, existing silkscreen and cut edges. Gerbers, STEP
    and renders regenerated; plates are plain again.
    [unicorne-choc-plate.dxf, unicorne-choc-plate.kicad_pcb, unicorne-choc-plate.step, unicorne-choc.kicad_pcb, unicorne-choc.step, unicorne-mx-plate.dxf, unicorne-mx-plate.kicad_pcb, unicorne-mx-plate.step]
2026-10-25 Point Choc diodes downward; make waves.py safe to re-run
    The Choc diode turns 90 degrees so anode-to-cathode points down the key, like
    MX. waves.py now strips the previous waves from the file text before loading,
    since deleting them through the Python bindings crashes.
    [gen_pcb.py, waves.py]
2026-10-25 Choc diode clears the LED data lane; router stitches lone GND islands
    The downward Choc diode sat on the LED data lane: it moves 0.6 mm up and the
    row stub takes a via just west of the cathode. finish_route.py now judges an
    attempt by DRC after the pours, and gives any GND pour island that has no via
    or through-hole GND pad its own stitching via.
2026-10-25 Reroute the Choc board with downward diodes
    DRC: 0 unconnected, 0 schematic parity issues, no copper errors. Gerbers, STEP,
    renders and plates regenerated.
    [unicorne-choc-plate.dxf, unicorne-choc-plate.kicad_pcb, unicorne-choc-plate.step, unicorne-choc.kicad_pcb, unicorne-choc.step, unicorne-mx-plate.dxf, unicorne-mx-plate.kicad_pcb, unicorne-mx-plate.step]
2026-10-25 Solid 42- and 36-key switch plates for MX and Choc; re-export everything
    Plates no longer have break lines. Each switch type gets a 42-key plate and a
    36-key plate cut where the PCB snaps off its outer columns, with rounded
    corners and only the holes whose screw head fits. PCB gerbers, STEP and
    renders regenerated.
    [unicorne-choc-36-plate.dxf, unicorne-choc-36-plate.kicad_pcb, unicorne-choc-36-plate.step, unicorne-choc-42-plate.dxf, unicorne-choc-42-plate.kicad_pcb, unicorne-choc-42-plate.step, unicorne-choc-plate.step, unicorne-choc.step]
2026-10-25 Cut the 36-key plates evenly on both sides
    The Choc PCB's break lines sit 8.4 / 10.6 mm from the outer key column because
    its sockets aren't mirrored; the plate now uses their average on both sides,
    so both 36-key plates are symmetric.
    [unicorne-choc-36-plate.dxf, unicorne-choc-36-plate.kicad_pcb, unicorne-choc-36-plate.step, unicorne-choc-42-plate.dxf, unicorne-choc-42-plate.kicad_pcb, unicorne-choc-42-plate.step, unicorne-mx-36-plate.dxf, unicorne-mx-36-plate.kicad_pcb]
2026-10-25 nice!nano and reset on top, TS-1136 H4.3 reset, USB notch; reroute both boards
    - nice!nano moves to the top side, components up; the centre parts mirror so
    power switch and reset sit by RAW/RST and the LED parts and headers by
    P0.06. SMD parts stay on the bottom.
    - Reset is now a TS-1136 H4.3 (6.0 x 3.5 mm, 2 pins 6.5 mm apart, 1.3 mm
    holes, from its drawing) on the top beside the nano.
    - The board edge is notched for the nano's mid-mount USB-C, whose shell drops
    0.7 mm below the nano's underside.
    - finish_route.py: 10 attempts by default, and dangling stubs are removed.
    - Both boards rerouted: DRC 0 unconnected, schematic parity 0, every pin,
    the matrix and the LED chain verified.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
    [leds.kicad_sch, matrix.kicad_sch, unicorne-choc-36-plate.dxf, unicorne-choc-36-plate.kicad_pcb, unicorne-choc-36-plate.step, unicorne-choc-42-plate.dxf, unicorne-choc-42-plate.kicad_pcb, unicorne-choc-42-plate.step]
2026-10-25 Halves closer, trackpad on the case; GND repair in the router; re-export
    - The trackpad sits on the case above the board, so it may cover the
    nice!nano. layout.py places it where its keycap keep-out lets the halves
    come closest: each half moves 3.25 mm inward and the board is 293.4 mm wide
    (was 299.9). The parts below it follow; it has no 3D model on the board.
    - The level shifter group (U2, C2, JP3) moves down, clear of the inner
    column, which now comes within ~6.5 mm of the headers.
    - J3/J4 headers have no 3D model (bare holes in the renders and STEP).
    - finish_route.py: jitters the routing order between attempts, and repairs
    GND the pours left cut off (tools/gnd_repair.py: a via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
    [leds.kicad_sch, matrix.kicad_sch, unicorne-choc-36-plate.dxf, unicorne-choc-36-plate.kicad_pcb, unicorne-choc-36-plate.step, unicorne-choc-42-plate.dxf, unicorne-choc-42-plate.kicad_pcb, unicorne-choc-42-plate.step]
2026-10-25 Plates: openings for the nice!nano (through the top edge) and the reset switch
    Both from where the PCB has them, 0.5 mm clearance, 0.8 mm corner radius. The
    nano opening joins the trackpad opening; all four plates pass DRC.
    Claude-Session: https://claude.ai/code/session_01D39ubfTYtq6FMvNmmbStTo
    [unicorne-choc-36-plate.dxf, unicorne-choc-36-plate.kicad_pcb, unicorne-choc-36-plate.step, unicorne-choc-42-plate.dxf, unicorne-choc-42-plate.kicad_pcb, unicorne-choc-42-plate.step, unicorne-mx-36-plate.dxf, unicorne-mx-36-plate.kicad_pcb]
2026-10-25 Layout page: nice!nano and reset on top, trackpad on the case, routed holes
    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
2026-10-25 Waves end in smooth curves around parts
    Rounded halos around every courtyard, pad and silkscreen outline (the whole
    outline a footprint draws, so the nice!nano and the pin table stay clear),
    merged where parts are close, and no pieces shorter than 3 mm.
    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
    [unicorne-choc.kicad_pcb, unicorne.kicad_pcb]
2026-10-25 Top-side waves run over everything except copper, holes and text
    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
    [unicorne-choc.kicad_pcb, unicorne.kicad_pcb]
2026-10-25 0603 resistors and capacitors; rerouted; router rescues stuck signals
    - R1-R5, C1, C2 move to KiCad's 0603 hand-solder footprints (README and the
    layout page updated). The last 0805 version is tagged working_0805.
    - finish_route.py: when every attempt leaves a signal unrouted, lift one
    neighbouring net in the way, route the connection, reroute the lifted net,
    and keep it only if nothing new is left unrouted. Tracks are removed by
    editing the board file, since removing them through the bindings breaks
    them.
    - Both boards: DRC 0 unconnected, schematic parity 0, every pin, the matrix,
    the LED chain and one GND group verified. Gerbers, STEP, renders and plates
    regenerated.
    Co-Auth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
    [leds.kicad_sch, matrix.kicad_sch, unicorne-choc-36-plate.dxf, unicorne-choc-36-plate.kicad_pcb, unicorne-choc-36-plate.step, unicorne-choc-42-plate.dxf, unicorne-choc-42-plate.kicad_pcb, unicorne-choc-42-plate.step]
2026-10-26 Route both boards with KiCadRoutingTools; no vias in pads
    tools/krt_route.py: fixed lanes, then KiCadRoutingTools 0.23.7 for every other
    signal at standard JLCPCB sizes (0.6/0.3 vias, 0.2 tracks) with no via in or next
    to a pad, own net's included; the maze router for any net it could only finish
    with undersized vias; GND pours and stitching; its plane repair; then any via
    touching a pad is removed. The tools relax the project's rules on disk: ours are
    put back.
    MX lanes: LED_VDD's jog across a break line moves from 5.5 to 4.5 mm off the
    line. At 5.5 it boxed in the outer-column LED DIN pads, so 8 LED data links had
    no room for a via outside a pad. Lane-only board: no DRC errors.
    Stitching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
    [led-map.csv, leds.kicad_sch, matrix.kicad_sch, unicorne-choc-36-plate.dxf, unicorne-choc-36-plate.kicad_pcb, unicorne-choc-36-plate.step, unicorne-choc-42-plate.dxf, unicorne-choc-42-plate.kicad_pcb]
2026-10-26 krt_route.py: always refill the pours under the board's own rules
    The plane repair fills under KiCadRoutingTools' relaxed clearances. The refill
    only ran when a via was removed from a pad, so a board with none kept pours
    too close to the NPTH holes (the committed boards were refilled by waves.py).
    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
    [krt_route.py]
